9zigen/wirelessmeteo/photos/clear/meteo_build_receiver_1.jpg

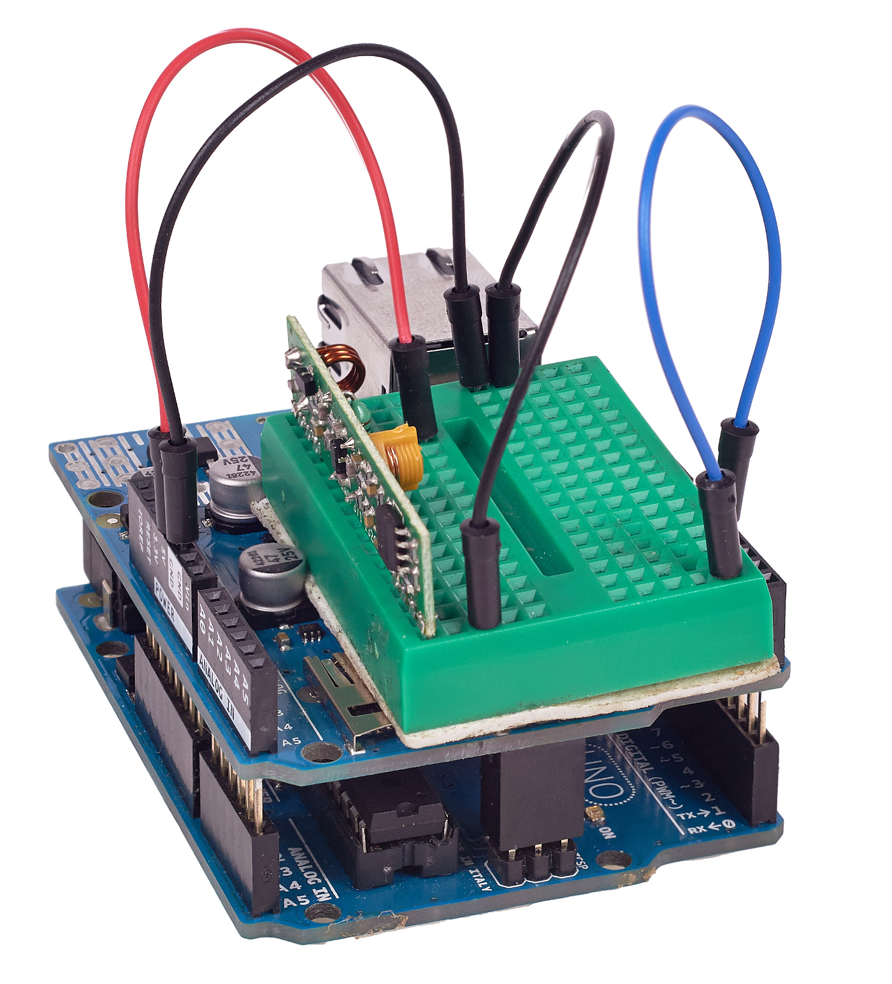
photos/clear/meteo_build_receiver_1.jpg
