9zigen/wirelessmeteo/photos/clear/meteo_build_sender_4.jpg

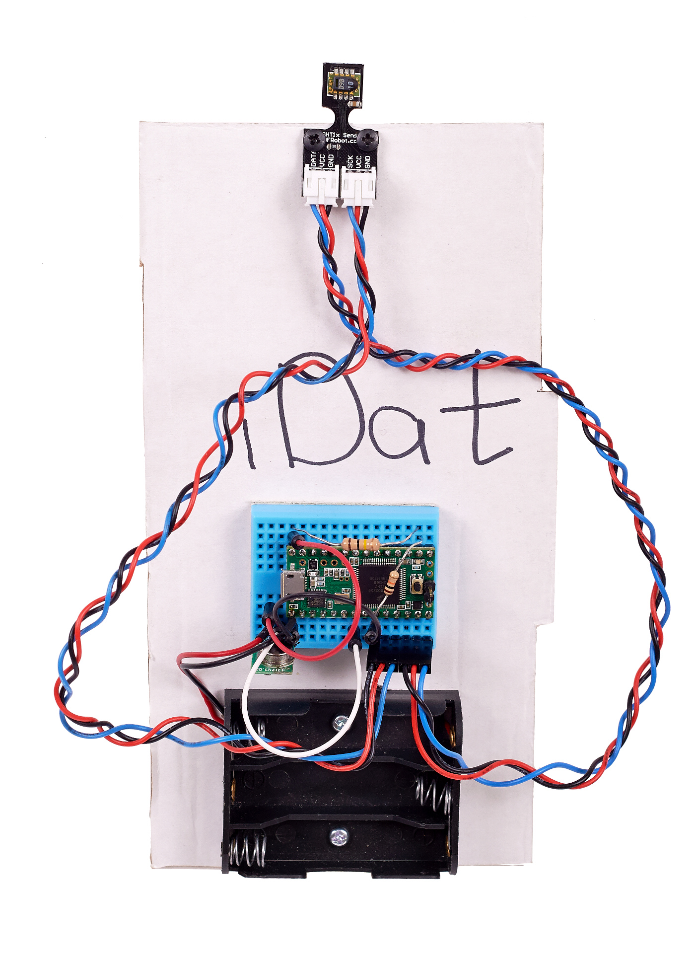
photos/clear/meteo_build_sender_4.jpg
