9zigen/wirelessmeteo/README.md

wirelessmeteo
=============

Wireless meteo station on Teensy 3.1 and Arduino Ethernet
