9zigen/wirelessmeteo/photos/clear/meteo_collage.jpg

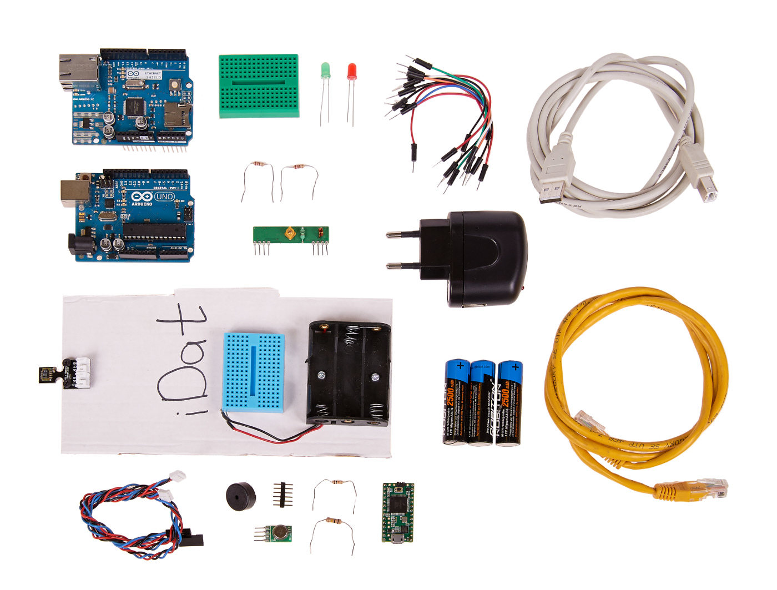
photos/clear/meteo_collage.jpg
