9zigen/wirelessmeteo/photos/clear/meteo_overview.jpg

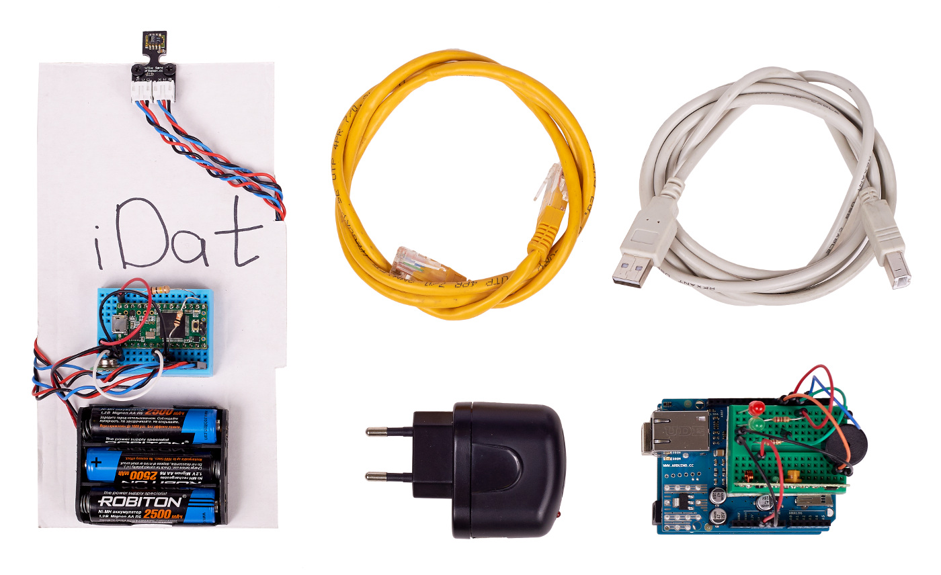
photos/clear/meteo_overview.jpg
