9zigen/wirelessmeteo/wiki/images/meteo_register.png

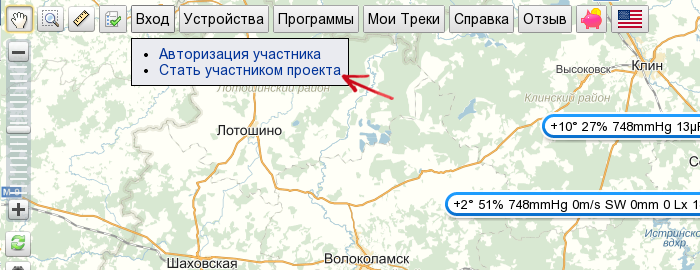
wiki/images/meteo_register.png
