9zigen/wirelessmeteo/wiki/images/meteo_sensorsfix.png

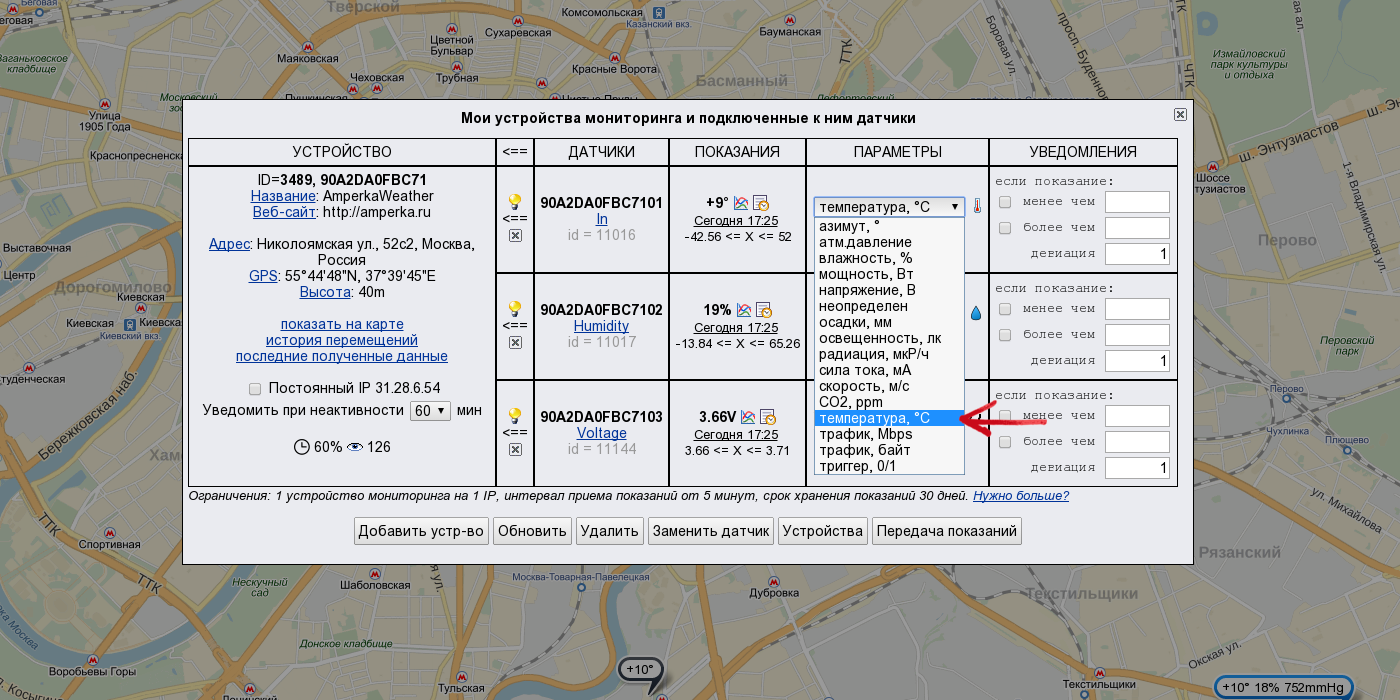
wiki/images/meteo_sensorsfix.png
