9zigen/wirelessmeteo/photos/clear/meteo_build_receiver_0.jpg

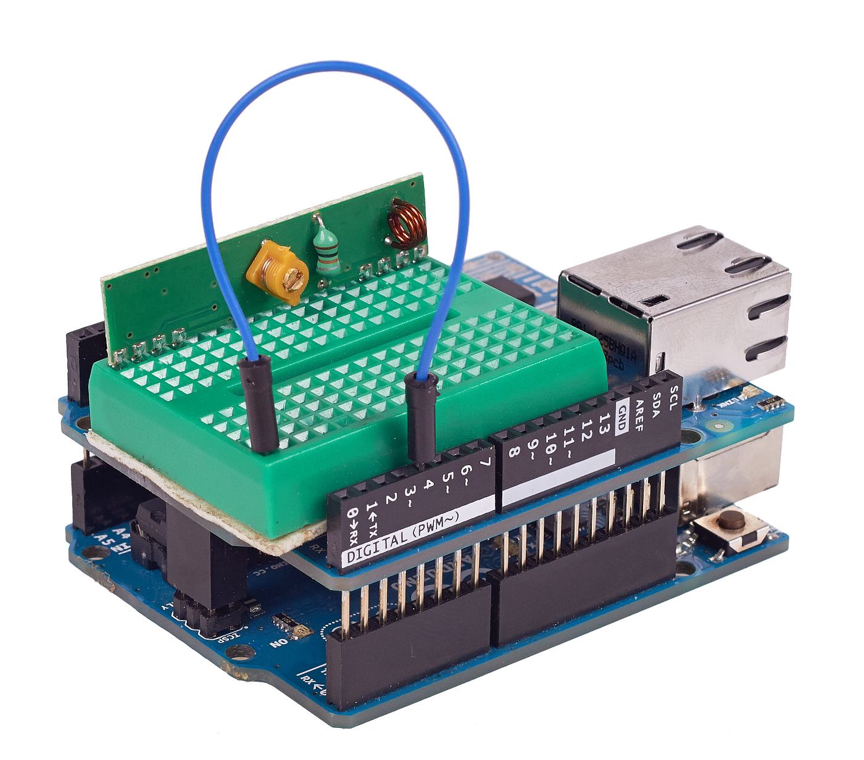
photos/clear/meteo_build_receiver_0.jpg
