9zigen/wirelessmeteo/photos/clear/meteo_build_receiver_2.jpg

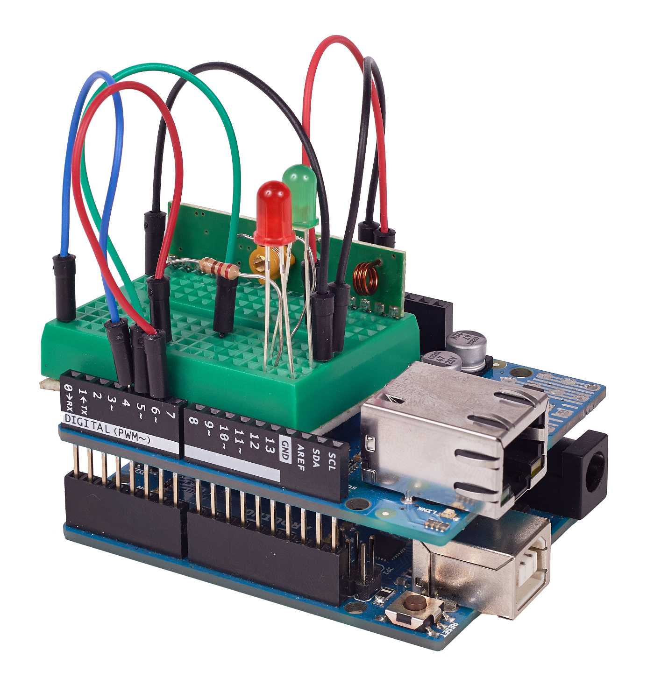
photos/clear/meteo_build_receiver_2.jpg
