9zigen/wirelessmeteo/photos/clear/meteo_build_receiver_3.jpg

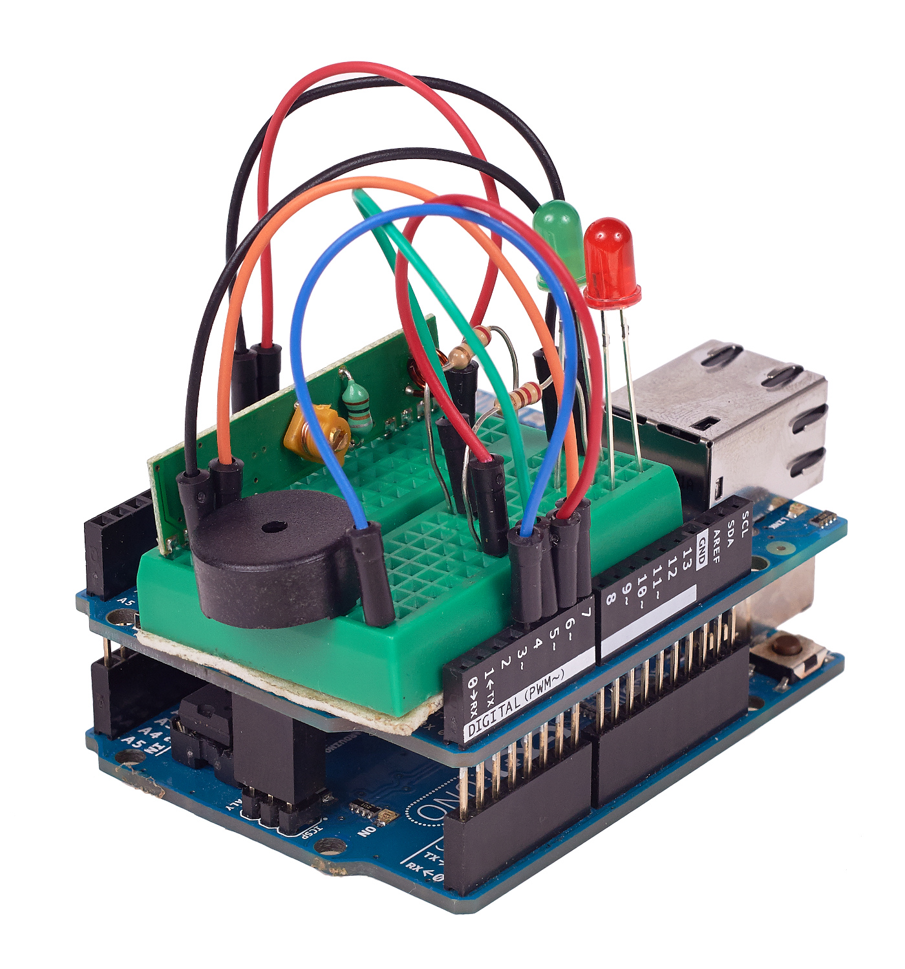
photos/clear/meteo_build_receiver_3.jpg
