9zigen/wirelessmeteo/photos/clear/meteo_build_sender_0.jpg

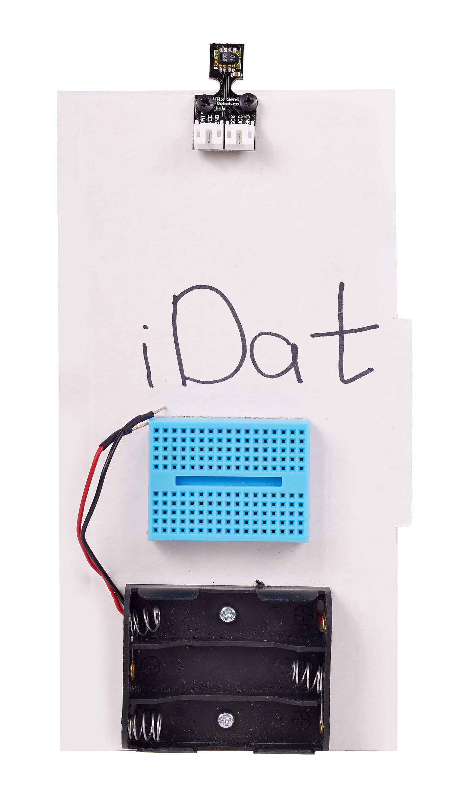
photos/clear/meteo_build_sender_0.jpg
