9zigen/wirelessmeteo/photos/clear/meteo_build_sender_1.jpg

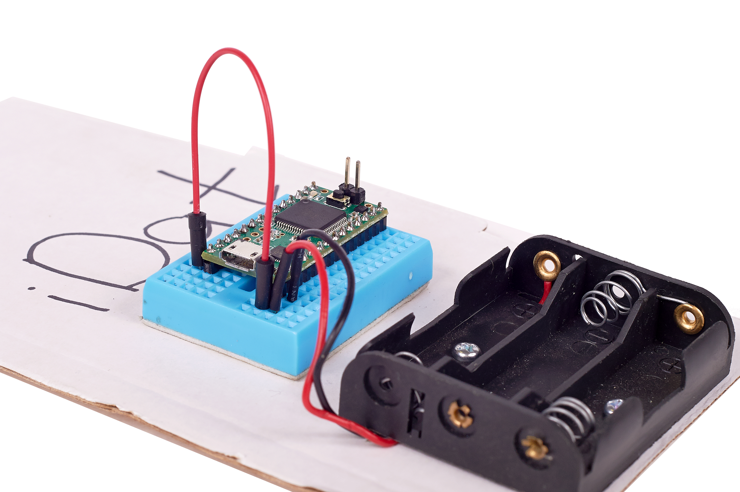
photos/clear/meteo_build_sender_1.jpg
