9zigen/wirelessmeteo/photos/clear/meteo_build_sender_2.jpg

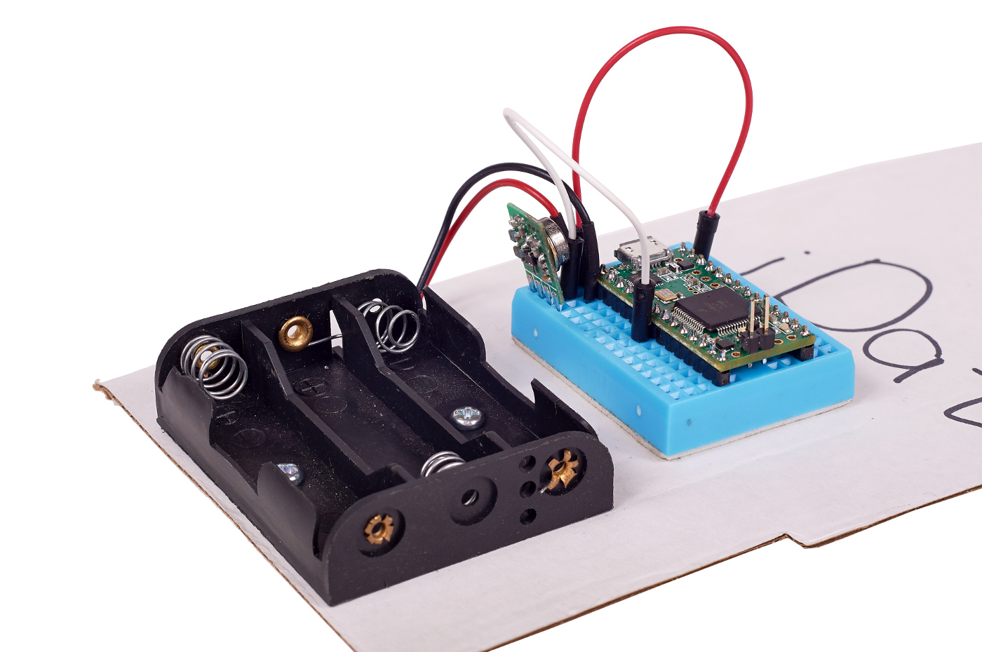
photos/clear/meteo_build_sender_2.jpg
