9zigen/wirelessmeteo/photos/clear/meteo_build_sender_3.jpg

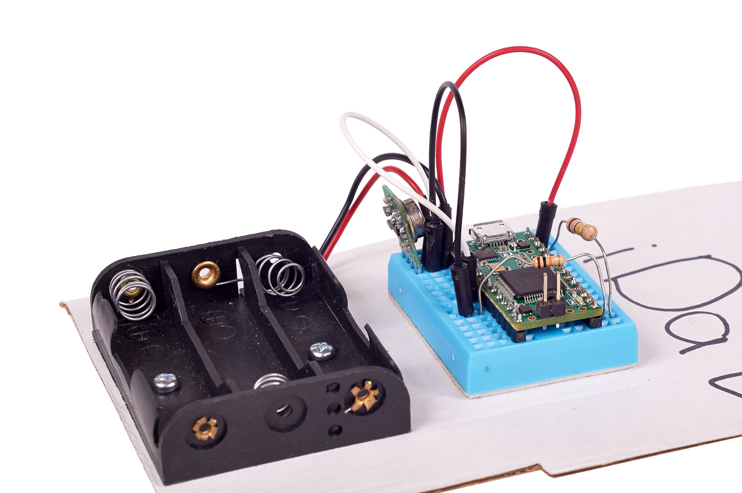
photos/clear/meteo_build_sender_3.jpg
